moinocencio/E4SC/KiCad Files/README.md

# PCB and Schematics

The current version of the controller has some functionalities implemented mainly for the University project, that don't have any use as of now.

The custom Footprints were made to adjust to our University CNC, but the PCB has the default Kicad footprints.
