moinocencio/E4SC/KiCad Files/ESC.sch.svg.png

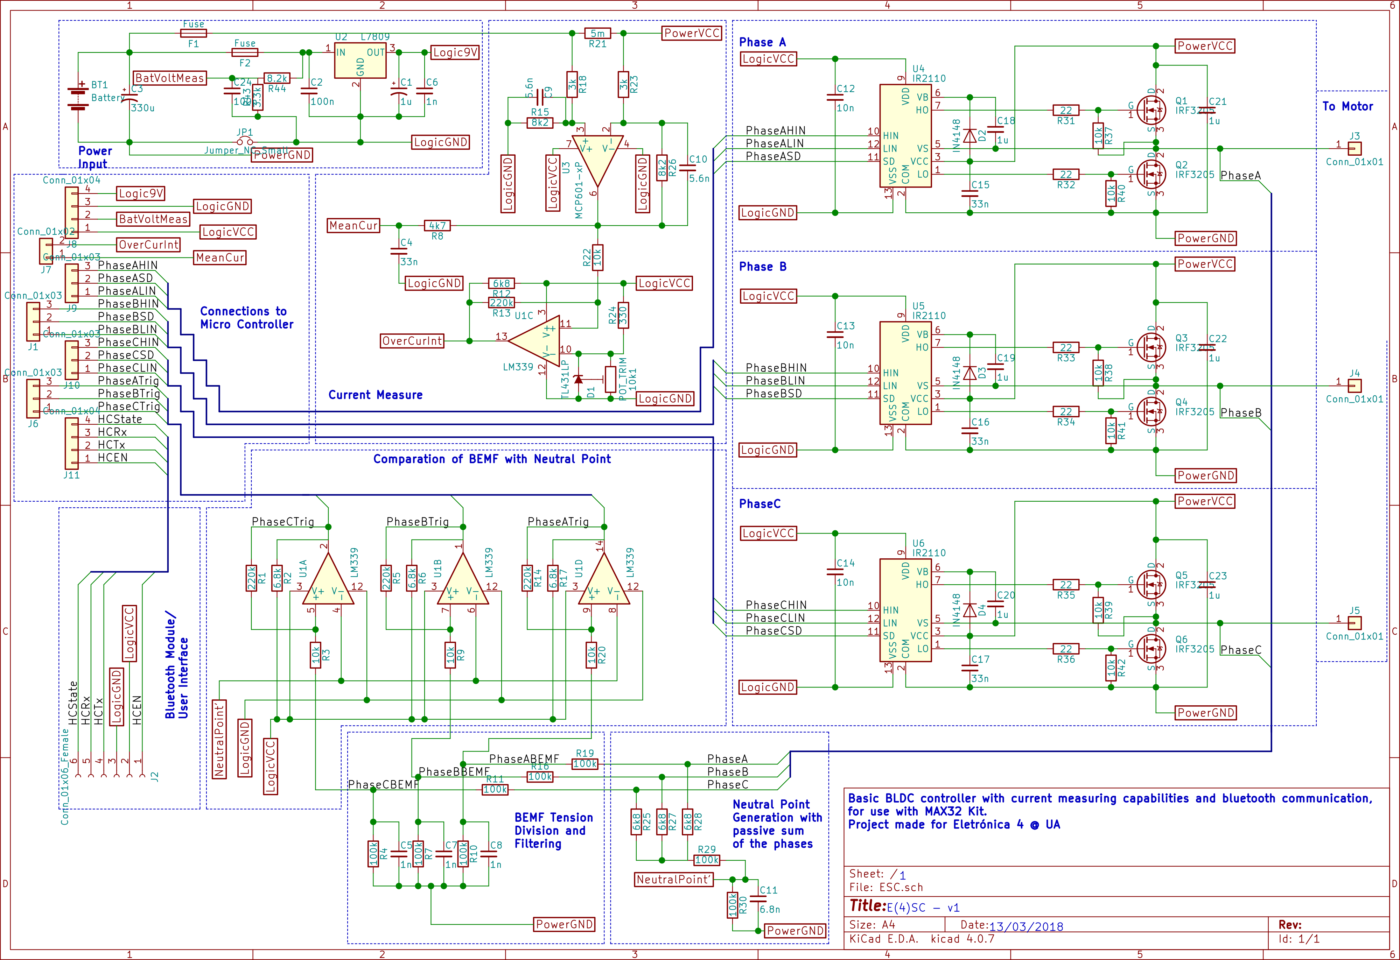
KiCad Files/ESC.sch.svg.png
