moinocencio/E4SC/KiCad Files/ESC.pdf

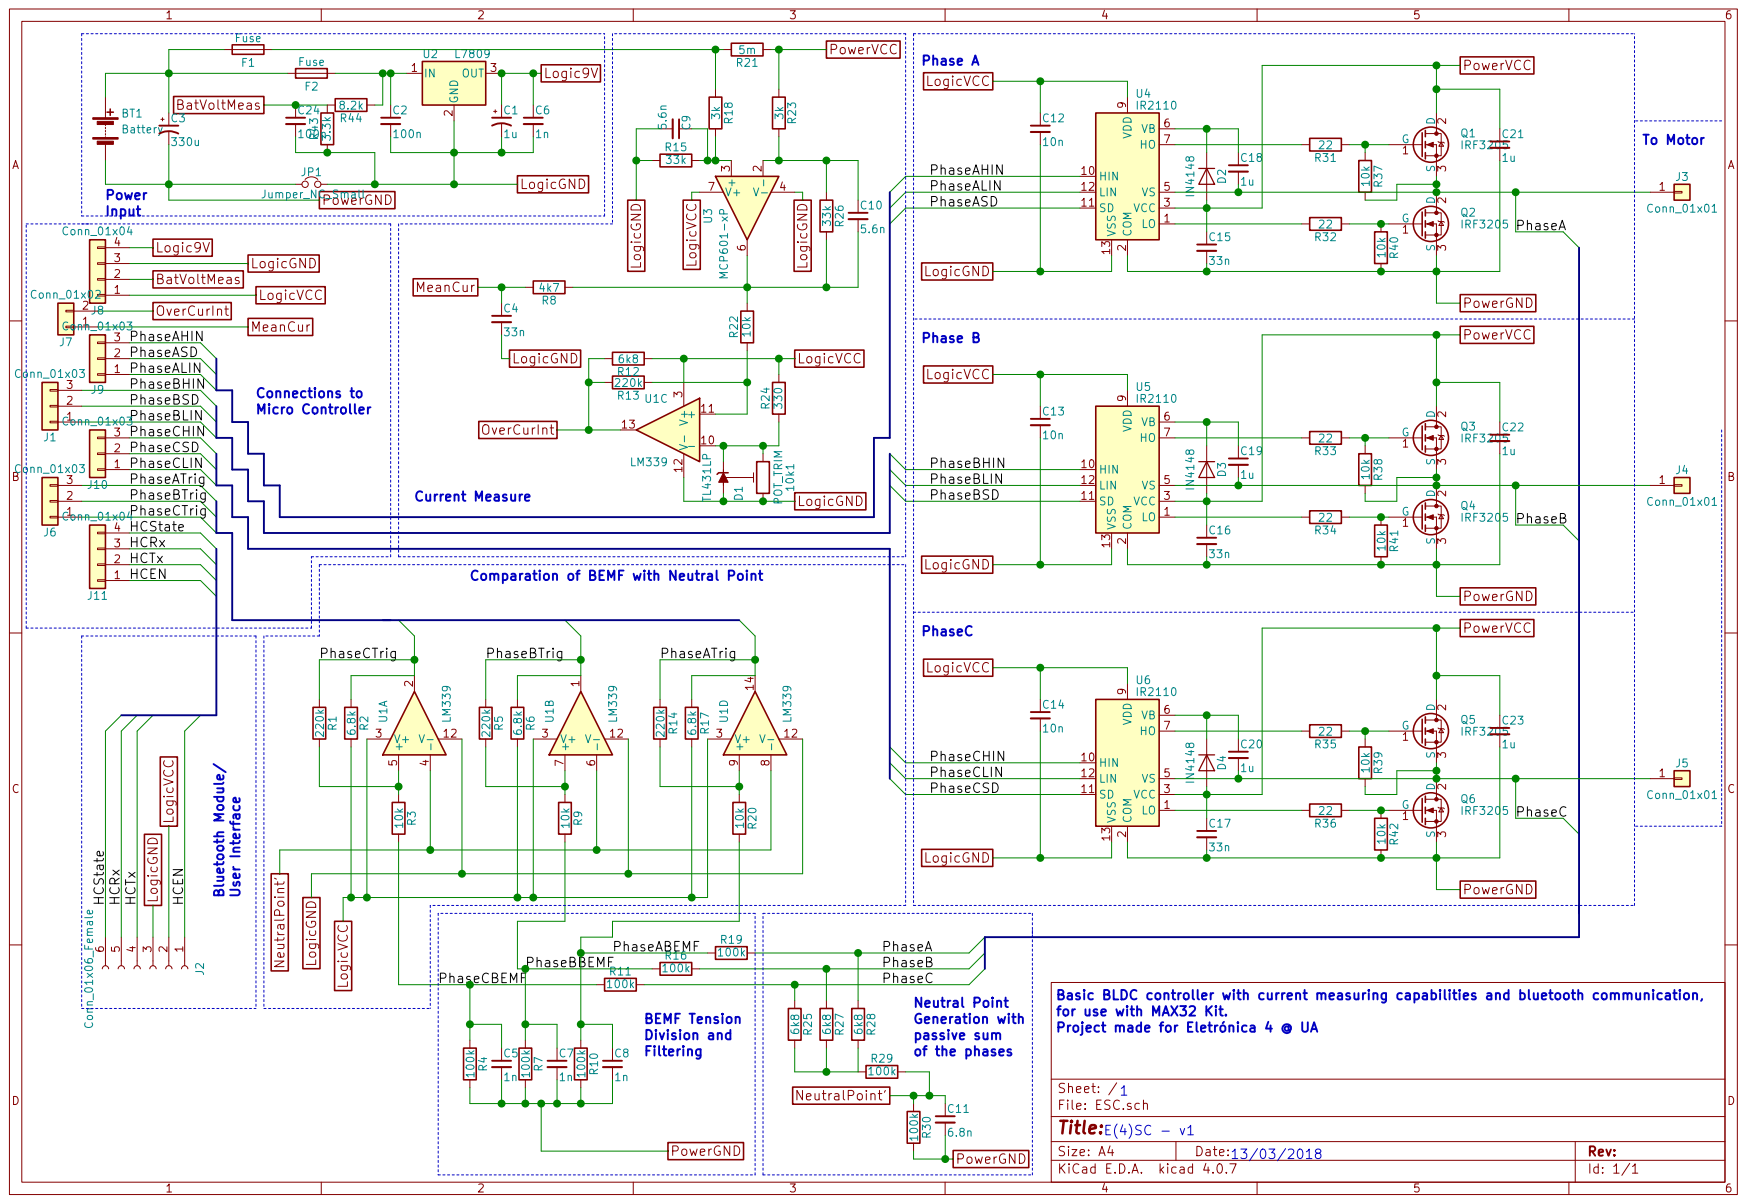
[picture p2: page 1]
