moinocencio/E4SC/KiCad Files/ESC.kicad_pcb

## KiCad design KiCad Files/ESC.kicad_pcb (2018-05-14)

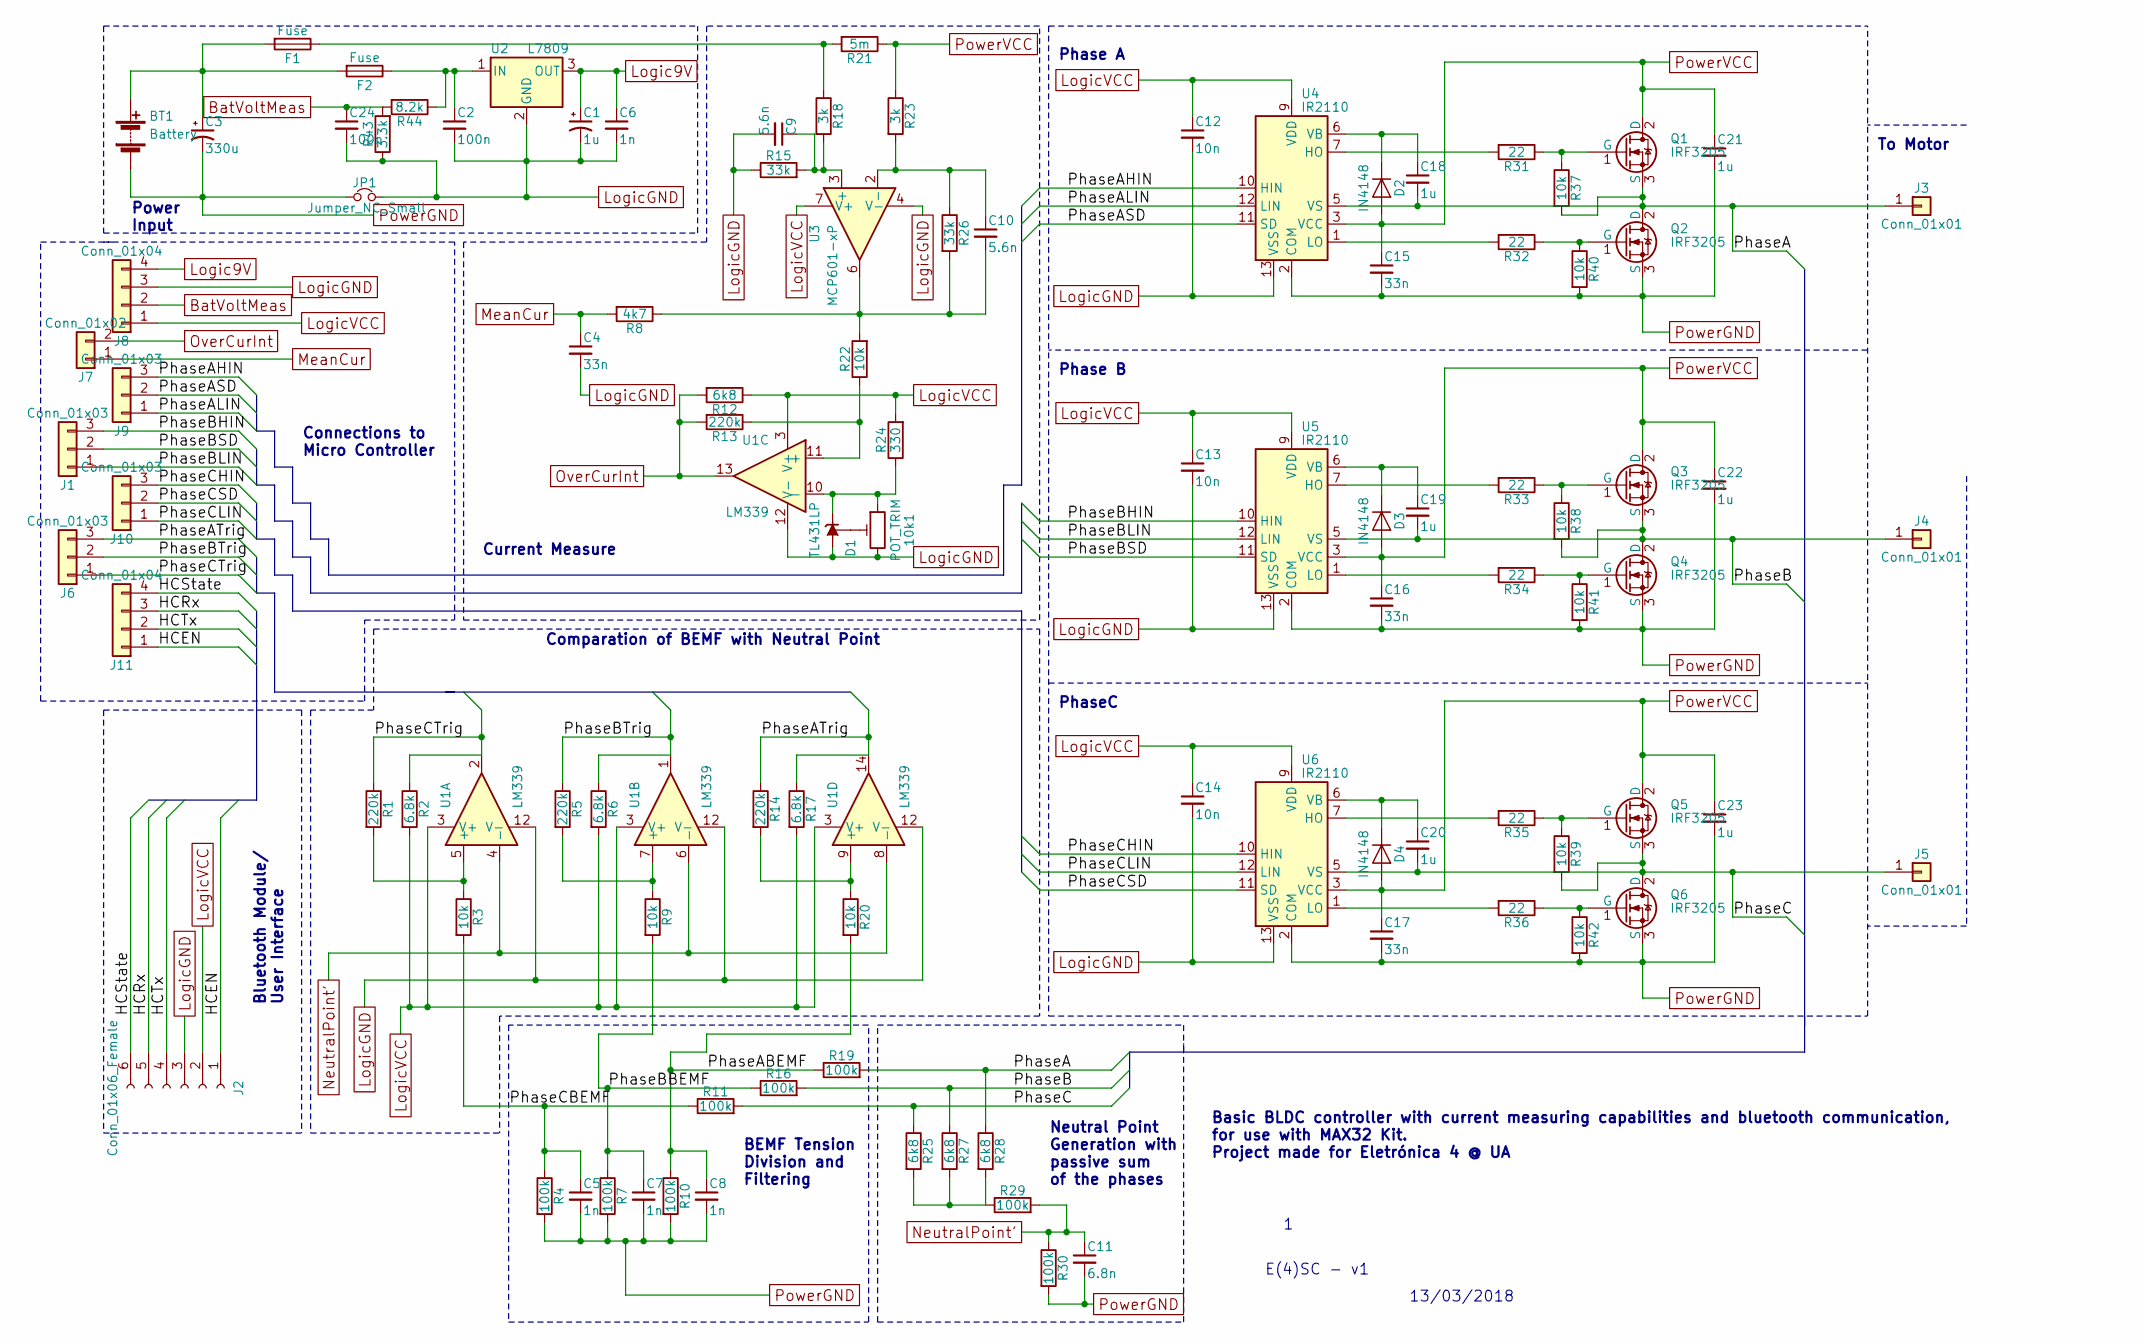
[picture p3: schematic ESC.sch]

Parts:
10k1: POT_TRIM; Potentiometer_WirePads_Small
BT1: Battery; WireConnection_2.50mmDrill_LargePad
C1: 1u; CP_Radial_D4.0mm_P2.00mm
C2, C24: 100n; C_1206_HandSoldering
C3: 330u; CP_Radial_D12.5mm_P7.50mm
C4, C15, C16, C17: 33n; C_1206_HandSoldering
C5, C6, C7, C8: 1n; C_1206_HandSoldering
C9, C10: 5.6n; C_1206_HandSoldering
C11: 6.8n; C_1206_HandSoldering
C12, C13, C14: 10n; C_1206_HandSoldering
C18, C19, C20: 1u; C_1206_HandSoldering
C21, C22, C23: 1u; C_Disc_D4.3mm_W1.9mm_P5.00mm
D1: TL431LP; TO-92_Inline_Narrow_Oval
D2, D3, D4: IN4148; D_DO-35_SOD27_P7.62mm_Horizontal
F1: Fuse; Fuseholder_ATO_Blade_littlefuse_Pudenz_2_Pin
F2: Fuse; Fuseholder5x20_horiz_open_inline_Type-I
J1, J6, J9, J10: Conn_01x03; Socket_Strip_Straight_1x03_Pitch2.54mm
J2: Conn_01x06_Female; Socket_Strip_Angled_1x06_Pitch2.54mm
J3, J4, J5: Conn_01x01; MountingHole_4.3mm_M4_Pad
J7: Conn_01x02; Socket_Strip_Straight_1x02_Pitch2.54mm
J8, J11: Conn_01x04; Socket_Strip_Straight_1x04_Pitch2.54mm
JP1: Jumper_NC_Small; CP_Tantalum_Case-A_EIA-3216-18_Hand
Q1, Q2, Q3, Q4, Q5, Q6: IRF3205; TO-220
R1, R5, R13, R14: 220k; R_1206_HandSoldering
R2, R6, R17: 6.8k; R_1206_HandSoldering
R3, R9, R20, R22, R37, R38, R39, R40, R41, R42: 10k; R_1206_HandSoldering
R4, R7, R10, R11, R16, R19, R29, R30: 100k; R_1206_HandSoldering
R8: 4k7; R_1206_HandSoldering
R12, R25, R27, R28: 6k8; R_1206_HandSoldering
R15, R26: 33k; R_1206_HandSoldering
R18, R23: 3k; R_1206_HandSoldering
R21: 5m; R_Axial_Power_L25.0mm_W9.0mm_P30.48mm
R24: 330; R_1206_HandSoldering
R31, R32, R33, R34, R35, R36: 22; R_1206_HandSoldering
R43: 3.3k; R_1206_HandSoldering
R44: 8.2k; R_1206_HandSoldering
U1: LM339; DIP-14_W7.62mm_Socket
U2: L7809; TO-220-3_Vertical
U3: MCP601-xP; DIP-8_W7.62mm_Socket
U4, U5, U6: IR2110; DIP-14_W7.62mm

Connections:
/PhaseA: C18.2, J3.1, Q1.3 (S), Q2.2 (D), R19.2, R28.1, R37.2, U4.5 (VS)
/PhaseABEMF: C8.1, R10.1, R19.1, R20.2
/PhaseAHIN: J9.3, U4.10 (HIN)
/PhaseALIN: J9.1, U4.12 (LIN)
/PhaseASD: J9.2, U4.11 (SD)
/PhaseATrig: J6.3, R14.1, R17.1, U1.14
/PhaseB: C19.2, J4.1, Q3.3 (S), Q4.2 (D), R16.2, R27.1, R38.2, U5.5 (VS)
/PhaseBBEMF: C7.1, R7.1, R9.2, R16.1
/PhaseBHIN: J1.3, U5.10 (HIN)
/PhaseBLIN: J1.1, U5.12 (LIN)
/PhaseBSD: J1.2, U5.11 (SD)
/PhaseBTrig: J6.2, R5.1, R6.1, U1.1
/PhaseC: C20.2, J5.1, Q5.3 (S), Q6.2 (D), R11.2, R25.1, R39.2, U6.5 (VS)
/PhaseCBEMF: C5.1, R3.2, R4.1, R11.1
/PhaseCHIN: J10.3, U6.10 (HIN)
/PhaseCLIN: J10.1, U6.12 (LIN)
/PhaseCSD: J10.2, U6.11 (SD)
/PhaseCTrig: J6.1, R1.1, R2.1, U1.2
BatVoltMeas: C24.1, J8.2, R43.2, R44.2
Logic9V: C1.1, C6.1, J8.4, U2.3 (OUT)
LogicGND: 10k1.3, C1.2, C2.2, C4.2, C6.2, C9.2, C12.2, C13.2, C14.2, C24.2, D1.2 (A), J2.3, J8.3, JP1.2, R15.1, R43.1, U1.12 (V-), U2.2 (GND), U3.4 (V-), U4.13 (VSS), U5.13 (VSS), U6.13 (VSS)
LogicVCC: C12.1, C13.1, C14.1, J2.2, J8.1, R2.2, R6.2, R12.1, R17.2, R24.2, U1.3 (V+), U3.7 (V+), U4.9 (VDD), U5.9 (VDD), U6.9 (VDD)
MeanCur: C4.1, J7.1, R8.2
unnamed: 10k1.1, D1.3 (K), R24.1, U1.10 (-)
unnamed: 10k1.2, D1.1 (REF)
unnamed: BT1.1 (+), C3.1, F1.2, F2.2
unnamed: C2.1, F2.1, R44.1, U2.1 (IN)
unnamed: C9.1, R15.2, R18.2, U3.3 (+)
unnamed: C10.1, R23.2, R26.1, U3.2 (-)
unnamed: C10.2, R8.1, R22.2, R26.2, U3.6
unnamed: C18.1, D2.1 (K), U4.6 (VB)
unnamed: C19.1, D3.1 (K), U5.6 (VB)
unnamed: C20.1, D4.1 (K), U6.6 (VB)
unnamed: F1.1, R18.1, R21.2
unnamed: J2.1, J11.1
unnamed: J2.4, J11.2
unnamed: J2.5, J11.3
unnamed: J2.6, J11.4
unnamed: Q1.1 (G), R31.1, R37.1
unnamed: Q2.1 (G), R32.1, R40.1
unnamed: Q3.1 (G), R33.1, R38.1
unnamed: Q4.1 (G), R34.1, R41.1
unnamed: Q5.1 (G), R35.1, R39.1
unnamed: Q6.1 (G), R36.1, R42.1
unnamed: R1.2, R3.1, U1.5 (+)
unnamed: R5.2, R9.1, U1.7 (+)
unnamed: R13.1, R22.1, U1.11 (+)
unnamed: R14.2, R20.1, U1.9 (+)
unnamed: R25.2, R27.2, R28.2, R29.1
unnamed: R31.2, U4.7 (HO)
unnamed: R32.2, U4.1 (LO)
unnamed: R33.2, U5.7 (HO)
unnamed: R34.2, U5.1 (LO)
unnamed: R35.2, U6.7 (HO)
unnamed: R36.2, U6.1 (LO)
NeutralPoint': C11.1, R29.2, R30.1, U1.4 (-), U1.6 (-), U1.8 (-)
OverCurInt: J7.2, R12.2, R13.2, U1.13
PowerGND: BT1.2 (-), C3.2, C5.2, C7.2, C8.2, C11.2, C15.2, C16.2, C17.2, C21.2, C22.2, C23.2, JP1.1, Q2.3 (S), Q4.3 (S), Q6.3 (S), R4.2, R7.2, R10.2, R30.2, R40.2, R41.2, R42.2, U4.2 (COM), U5.2 (COM), U6.2 (COM)
PowerVCC: C15.1, C16.1, C17.1, C21.1, C22.1, C23.1, D2.2 (A), D3.2 (A), D4.2 (A), Q1.2 (D), Q3.2 (D), Q5.2 (D), R21.1, R23.1, U4.3 (VCC), U5.3 (VCC), U6.3 (VCC)

Notes on the sheet:
E(4)SC - v1
13/03/2018
Power Input
Phase A
Phase B
PhaseC
Connections to Micro Controller
To Motor
Bluetooth Module/ User Interface
Neutral Point Generation with passive sum of the phases
BEMF Tension Division and Filtering
Comparation of BEMF with Neutral Point
Current Measure
Basic BLDC controller with current measuring capabilities and bluetooth communication, for use with MAX32 Kit. Project made for Eletrónica 4 @ UA

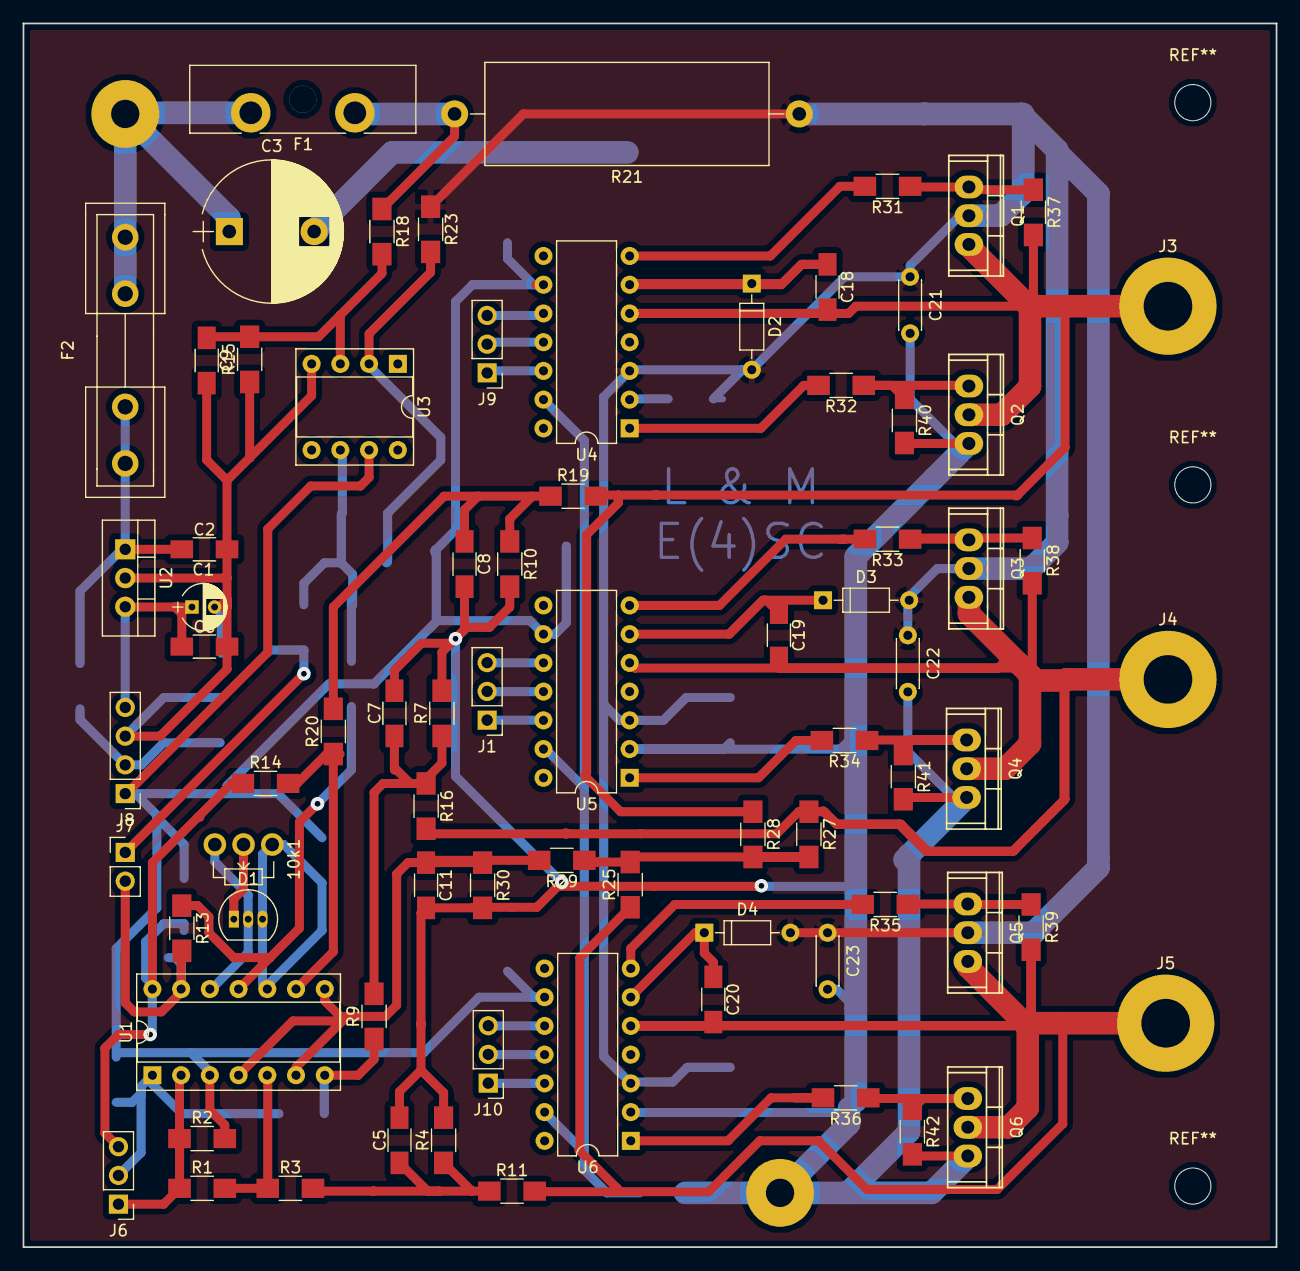
[picture p4: board ESC.kicad_pcb from above]

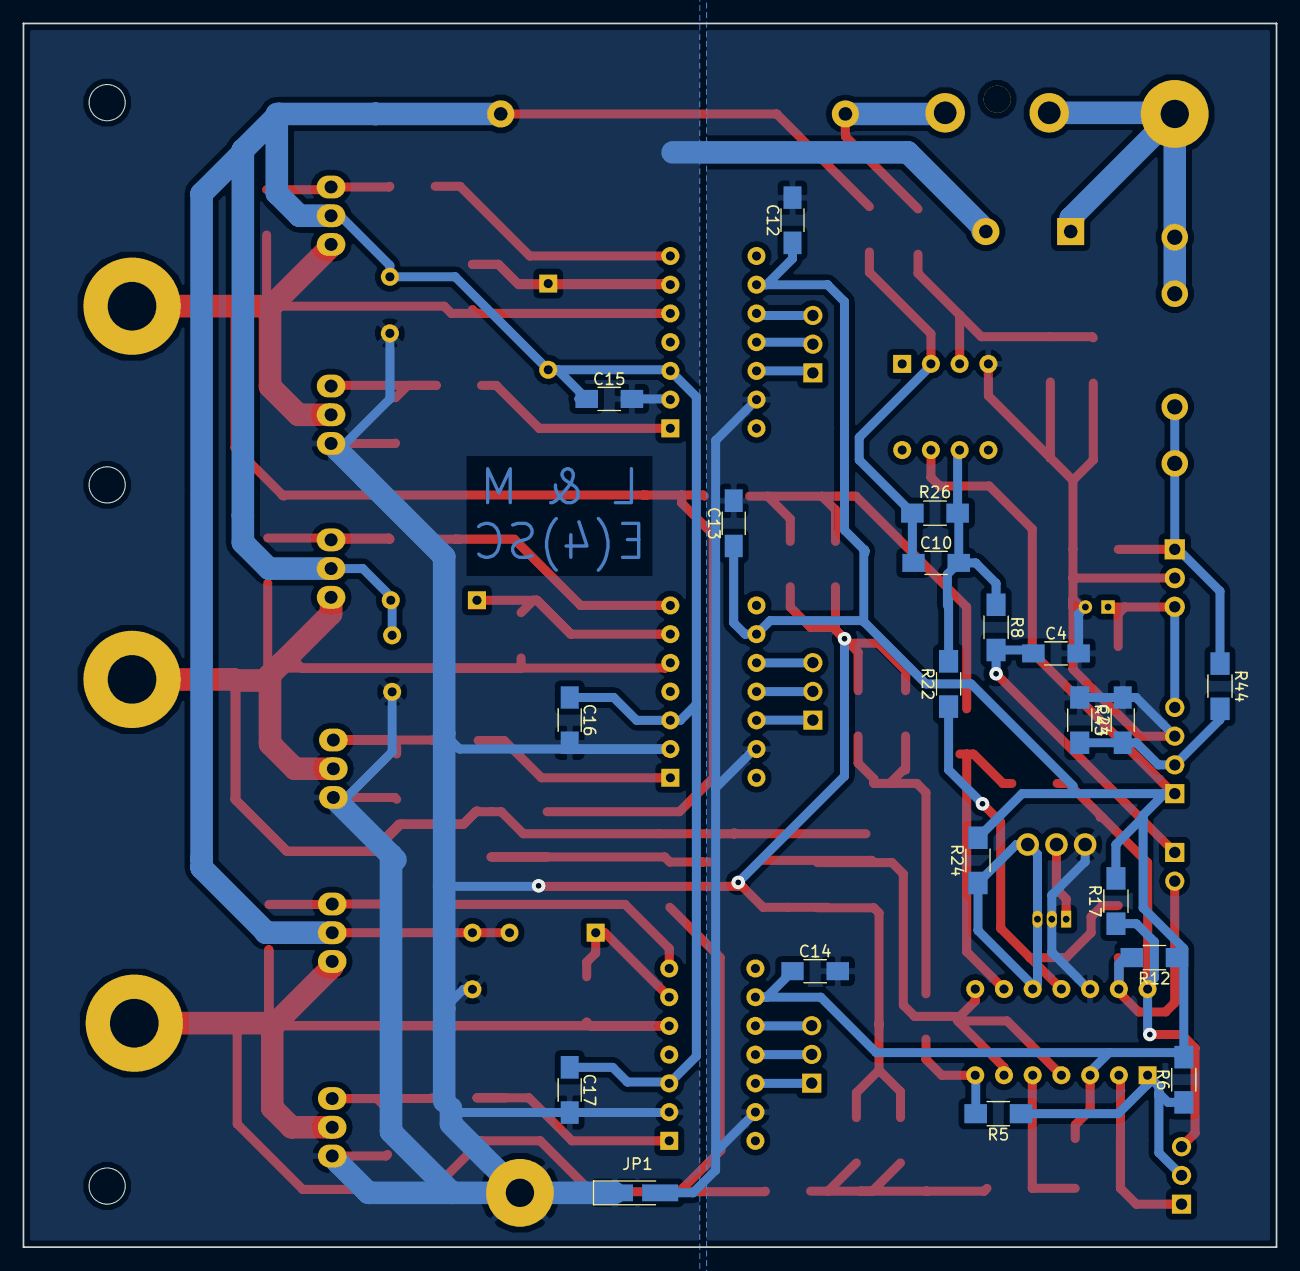
[picture p5: board ESC.kicad_pcb from below]

Board: 2 copper layers, 110.8 x 108.2 mm, 98 parts (20 on the bottom side), 55 nets.
