moinocencio/E4SC/PIC/blueTooth/bcom.X/config_bits.h

#ifndef __CONFIG_BITS_H__
#define __CONFIG_BITS_H__

    #pragma config FSRSSEL = PRIORITY_7     // SRS Select (SRS Priority 7)
    #pragma config FMIIEN = ON              // Ethernet RMII/MII Enable (MII Enabled)
    #pragma config FETHIO = ON              // Ethernet I/O Pin Select (Default Ethernet I/O)
    #pragma config FCANIO = ON              // CAN I/O Pin Select (Default CAN I/O)
    #pragma config FUSBIDIO = ON            // USB USID Selection (Controlled by the USB Module)
    #pragma config FVBUSONIO = ON           // USB VBUS ON Selection (Controlled by USB Module)

    // DEVCFG2
    #pragma config FPLLIDIV = DIV_2         // PLL Input Divider (2x Divider)
    #pragma config FPLLMUL = MUL_20         // PLL Multiplier (20x Multiplier)
    #pragma config UPLLIDIV = DIV_12        // USB PLL Input Divider (12x Divider)
    #pragma config UPLLEN = OFF             // USB PLL Enable (Disabled and Bypassed)
    #pragma config FPLLODIV = DIV_1         // System PLL Output Clock Divider (PLL Divide by 1)

    // DEVCFG1
    #pragma config FNOSC = PRIPLL           // Oscillator Selection Bits (Primary Osc w/PLL (XT+,HS+,EC+PLL))
    #pragma config FSOSCEN = ON             // Secondary Oscillator Enable (Enabled)
    #pragma config IESO = ON                // Internal/External Switch Over (Enabled)
    #pragma config POSCMOD = HS             // Primary Oscillator Configuration (HS osc mode)
    #pragma config OSCIOFNC = OFF           // CLKO Output Signal Active on the OSCO Pin (Disabled)
    #pragma config FPBDIV = DIV_2           // Peripheral Clock Divisor (Pb_Clk is Sys_Clk/2)
    #pragma config FCKSM = CSDCMD           // Clock Switching and Monitor Selection (Clock Switch Disable, FSCM Disabled)
    #pragma config WDTPS = PS1048576        // Watchdog Timer Postscaler (1:1048576)
    #pragma config FWDTEN = ON              // Watchdog Timer Enable (WDT Enabled)

    // DEVCFG0
    #pragma config DEBUG = OFF              // Background Debugger Enable (Debugger is disabled)
    #pragma config ICESEL = ICS_PGx2        // ICE/ICD Comm Channel Select (ICE EMUC2/EMUD2 pins shared with PGC2/PGD2)
    #pragma config PWP = OFF                // Program Flash Write Protect (Disable)
    #pragma config BWP = OFF                // Boot Flash Write Protect bit (Protection Disabled)
    #pragma config CP = OFF                 // Code Protect (Protection Disabled)

#endif
