moinocencio/E4SC/(commit log)

2018-04-17 Base Files Added
    [ESC.kicad_pcb, ESC.sch, chipkit_max32_pinout_table.xls]
2018-04-23 First version ADC
2018-04-23 UART and Configbits
2018-04-24 uptates adc-pwm-uart
2018-04-30 Updated v1 of PCB
    [ESC.sch]
2018-05-01 Finished PCB v1 and Started v2
    [ESC.kicad_pcb, ESC.sch, ESCv2.kicad_pcb]
2018-05-08 Added PCB v2 and reorganized code
    [ESC.kicad_pcb, ESC.sch, ESCv2.kicad_pcb]
2018-05-11 Added final PCB
    [Current Measures.ods, ESC.kicad_pcb, ESC.sch, chipkit_max32_pinout_table.xls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]
2018-05-14 Phase 2 files
    [Current Measures.ods]
2018-05-15 timers and adc update
2018-05-22 Update PCB and Phase 2
    [Current Measures.ods, ESC.sch]
2018-06-11 Final docs added
    [_saved_ESC.sch]
2018-06-22 Clean Repo
    [Current Measures.ods, _saved_ESC.sch]
